jjcastro5283/robotic-arm-esp32/cad/robotic_arm_assembly.step

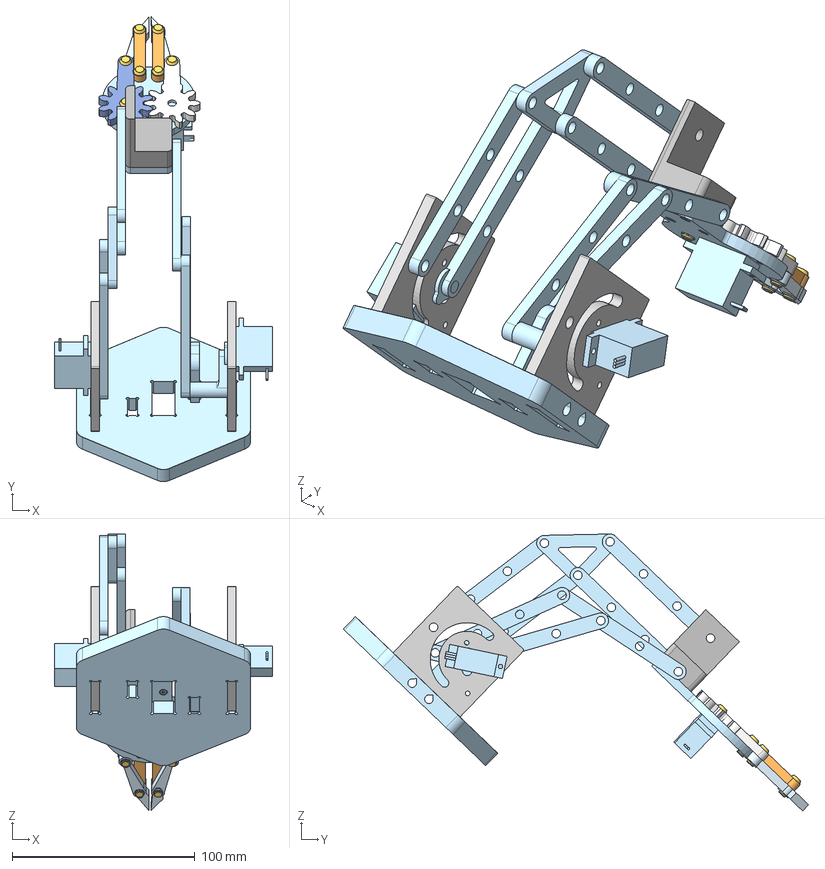
[picture p1: CAD file, 2026-10-17]
cad/robotic_arm_assembly.step
119.5 x 254.6 x 151.6 mm
BASE_WALL-MAIN x 2
Hex socket head cap screw M2x0.40 x 6 x 4
arm 2 x 2
Arm x 2
Pin x 7
Base
Spur gear (10 teeth) x 2
Grip_Bracket_classexample
