jjcastro5283/robotic-arm-esp32/(commit log)

2026-10-17 Add files via upload
    Initial commit: firmware, CAD model, wiring diagram, README
    [robotic_arm_assembly.step]
2026-10-17 Add files via upload
    Update README, license, and wiring diagram
2026-10-17 Add files via upload
    Update wiring diagram
